Tesla900/GSMLinkModem/Hardware/Info/Smart104.ua_V3_front.png

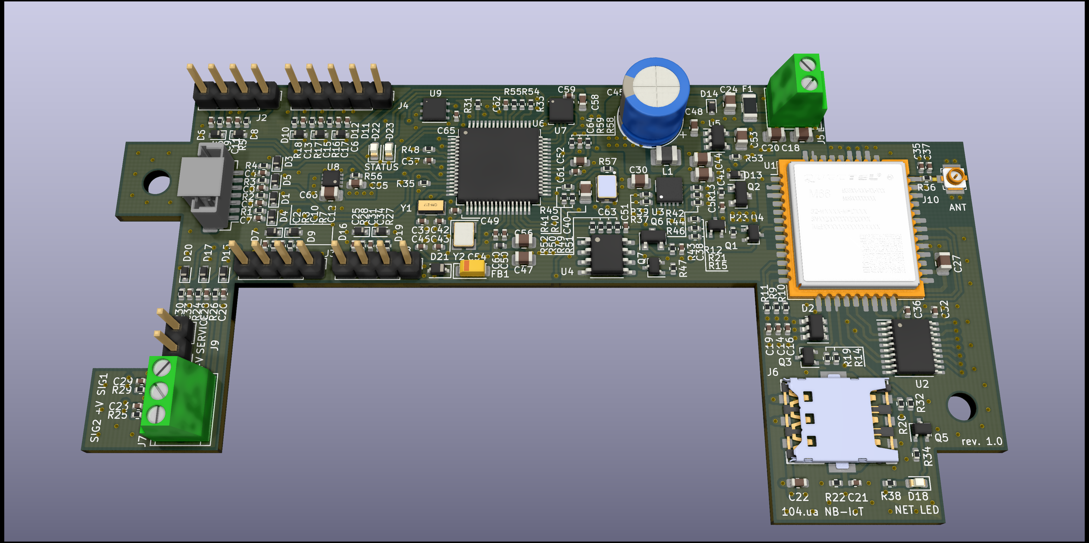
Hardware/Info/Smart104.ua_V3_front.png
