Tesla900/GSMLinkModem/Hardware/Info/Smart104.ua_V3_back.png

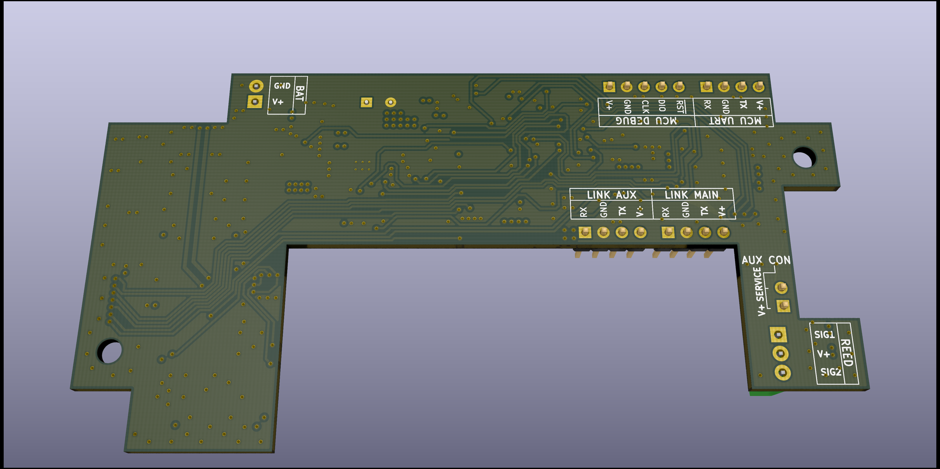
Hardware/Info/Smart104.ua_V3_back.png
