Tesla900/GSMLinkModem/README.md

# GSMLinkModem
EFM32TG222F32-QFP48T+BC66-NA/M66 GSM/GPRS/NB-IoT board
