Tesla900/GSMLinkModem/Hardware/ProductionFiles/assembly/Smart104.ua_V3_BOM.xlsx

Sheet: Лист1
Reference | Value/PartNumber | PartNumber | Qty | Description | Link | DoNotPlace Status
C3, C4, C7-C17, C19, C26, C28, C31, C33, C34 | 18pF | CC0402JRNPO9BN180 | 19 | 18pF ±5% 50V Ceramic Capacitor C0G, NP0 0402 (1005 Metric) | https://www.digikey.com/en/products/detail/yageo/CC0402JRNPO9BN180/2833580
C35, C37, C39, C42, C43, C46 | DNP | ~ | 6 | ~ | ~ | DNP
C45 | 1000uF | A750KK108M0JAAE015 | 1 | 1000µF 6.3V Aluminum - Polymer Capacitors Radial, Can 15mOhm 2000 Hrs @ 105°C | https://www.digikey.com/en/products/detail/kemet/a750kk108m0jaae015/6196437
C22, C48, C52, C55, C58 | 1uF | CC0603KRX7R7BB105 | 5 | 1µF ±10% 16V Ceramic Capacitor X7R 0603 (1608 Metric) | https://www.digikey.com/en/products/detail/yageo/CC0603KRX7R7BB105/2833611
C54 | 100uF | TCJA107M006R0150E | 1 | 100µF Molded Tantalum Polymer Capacitor 6.3V 1206 (3216 Metric) 150mOhm @ 100kHz | https://www.digikey.com/en/products/detail/avx-corporation/TCJA107M006R0150E/10062652
C18, C20, C24, C27, C30, C40, C41, C44, C47, C53, C56, C66 | 10uF | CC0805MKX7R7BB106 | 12 | 10µF ±20% 16V Ceramic Capacitor X7R 0805 (2012 Metric) | digikey.com/en/products/detail/yageo/CC0805MKX7R7BB106/7164392
C1, C2, C5, C6, C21, C23, C25, C29, C32, C36, C38, C49-C51, C57, C59-C62, C64, C65 | 0.1uF | CC0402KRX7R7BB104 | 21 | 0.1µF ±10% 16V Ceramic Capacitor X7R 0402 (1005 Metric) | https://www.digikey.com/en/products/detail/yageo/CC0402KRX7R7BB104/2103076
C63 | 11mF | CPH3225A | 1 | 11mF (EDLC) Supercapacitor 3.3V 1210 (3225 Metric) | https://www.digikey.com/en/products/detail/seiko-instruments/CPH3225A/8692444
D2 | ESDA6V1-5SC6 | ESDA6V1-5SC6 | 1 | Clamp 6.1V 100W TVS Diode Array Surface Mount SOT-23-6 | https://www.digikey.com/en/products/detail/stmicroelectronics/ESDA6V1-5SC6/1037983
D1, D3-D17, D19, D20 | PESD5V0L1UB,115 | PESD5V0L1UB,115 | 18 | 12V Clamp 3.5A (8/20µs) Ipp Tvs Diode Surface Mount SOD-523 | https://www.digikey.com/en/products/detail/nexperia-usa-inc/PESD5V0L1UB115/2092297
D21 | BAT46JFILM | BAT46JFILM | 1 | Diode Schottky 100V 150mA (DC), 0.46Vdrop Surface Mount SOD-323 | https://www.digikey.com/en/products/detail/stmicroelectronics/BAT46JFILM/1037668
D18, D22 | LED_RED | APT1608SURCK | 2 | Red 630nm LED Indication - Discrete 1.95V 0603 (1608 Metric) | https://www.digikey.com/en/products/detail/kingbright/APT1608SURCK/1747522
D23 | LED_GREEN | APT1608CGCK | 1 | Green 570nm LED Indication - Discrete 2.1V 0603 (1608 Metric) | https://www.digikey.com/en/products/detail/kingbright/APT1608CGCK/1747514
F1 | 0ZCJ0100FF2E | 0ZCJ0100FF2E | 1 | Polymeric PTC Resettable Fuse 6V 1A Ih Surface Mount 1206 (3216 Metric), Concave | https://www.digikey.com/en/products/detail/bel-fuse-inc/0ZCJ0100FF2E/4156136
FB1 | 1 kOhms @ 100MHz | BLM15AG102SN1D | 1 | 1 kOhms @ 100MHz 1 Ferrite Bead 0402 (1005 Metric) 300mA 650mOhm | https://www.digikey.com/en/products/detail/murata-electronics/BLM15AG102SN1D/584218
H1, H2 | MountingHole | Mounting screw M3 DIN965 | 2 | Mounting screw M3 DIN965 | ~ | DNP
J1 | 5013310707 | 5013310707 | 1 | Connector Header Surface Mount 7 position 0.039" (1.00mm) | https://www.digikey.com/en/products/detail/molex/5013310707/1531476
J2, J3, J8 | KLS1-207-1-04-S | KLS1-207-1-04-S | 3 | Connector Header Through Hole 4 position 0.100" (2.54mm) | http://www.klsele.com/products/connectors/Pin-Headers-Mini-Jumpers-Series/184.html
J4 | KLS1-207-1-05-S | KLS1-207-1-05-S | 1 | Connector Header Through Hole 5 position 0.100" (2.54mm) | http://www.klsele.com/products/connectors/Pin-Headers-Mini-Jumpers-Series/184.html
J5 | KLS2-308V-2.54-02P-4S | KLS2-308V-2.54-02P-4S | 1 | 2 Position Wire to Board Terminal Block Horizontal with Board 0.100" (2.54mm) Through Hole | http://www.klsele.com/products/Terminal-blocks/560/278.html
J6 | SIM8051-6-0-14-00-A | SIM8051-6-0-14-00-A | 1 | 6 Position Card Connector NANO SIM Surface Mount, Right Angle Gold | https://www.digikey.com/en/products/detail/gct/SIM8051-6-0-14-00-A/10649873?
J7 | KLS2-308V-2.54-03P-4S | KLS2-308V-2.54-03P-4S | 1 | 3 Position Wire to Board Terminal Block Horizontal with Board 0.100" (2.54mm) Through Hole | http://www.klsele.com/products/Terminal-blocks/560/278.html
J9 | KLS1-207-1-02-S | KLS1-207-1-02-S | 1 | Connector Header Through Hole 2 position 0.100" (2.54mm) | http://www.klsele.com/products/connectors/Pin-Headers-Mini-Jumpers-Series/184.html
J10 | 1909763-1 | 1909763-1 | 1 | U.FL (UMCC) Connector Jack, Male Pin 50Ohm Surface Mount Solder | https://www.digikey.com/en/products/detail/te-connectivity-amp-connectors/1909763-1/4731728
L1 | 2.2uH | DFE252010F-2R2M=P2 | 1 | 2.2µH Shielded Inductor 2.3A 97mOhm Max 1008 (2520 Metric) | https://www.digikey.com/en/products/detail/murata-electronics/DFE252010F-2R2M=P2/5812578
Q2, Q6 | AO3419 | AO3419 | 2 | P-Channel 20V 3.5A (Ta) 1.4W (Ta) Surface Mount SOT-23-3L | https://www.digikey.com/en/products/detail/alpha-omega-semiconductor-inc/AO3419/1855785
Q1, Q3-Q5, Q7 | BC847CW,115 | BC847CW,115 | 5 | Bipolar (BJT) Transistor NPN 45V 100mA 100MHz 200mW Surface Mount SOT-323 | https://www.digikey.com/en/products/detail/nexperia-usa-inc/BC847CW115/1232292
R36 | 0R | RC0402JR-070RL | 1 | 0 Ohms 0.063W, 1/16W Chip Resistor 0402 (1005 Metric) Thick Film | https://www.digikey.com/en/products/detail/yageo/RC0402JR-070RL/726406
R40 | 3M | RC0402FR-073ML | 1 | 3 MOhms ±1% 0.125W, 1/8W Chip Resistor 0402 (1005 Metric) Thick Film | https://www.digikey.com/en/products/detail/yageo/RC0402FR-073ML/5917669
R41 | 1M | RC0402FR-071ML | 1 | 1 MOhms ±1% 0.125W, 1/8W Chip Resistor 0402 (1005 Metric) Thick Film | https://www.digikey.com/en/products/detail/yageo/RC0402FR-071ML/726515
R42 | 16.2K | RC0402FR-0716K2L | 1 | 16.2 kOhms ±1% 0.063W, 1/16W Chip Resistor 0402 (1005 Metric) Thick Film | https://www.digikey.com/en/products/detail/yageo/RC0402FR-0716K2L/726545
R44 | 8.25K | RC0402FR-078K25L | 1 | 8.25 kOhms ±1% 0.125W, 1/8W Chip Resistor 0402 (1005 Metric) Thick Film | https://www.digikey.com/en/products/detail/yageo/RC0402FR-078K25L/2827612
R46 | 5.11K | RC0402FR-075K11L | 1 | 5.11 kOhms ±1% 0.125W, 1/8W Chip Resistor 0402 (1005 Metric) Thick Film | https://www.digikey.com/en/products/detail/yageo/RC0402FR-075K11L/2827606
R13, R15, R19, R20, R22, R23, R31, R33-R35, R37, R39, R43, R47, R53, R56 | 10K | RC0402FR-0710KL | 16 | 10 kOhms ±1% 0.063W, 1/16W Chip Resistor 0402 (1005 Metric) Thick Film | https://www.digikey.com/en/products/detail/yageo/RC0402FR-0710KL/726523
R12, R14, R21, R25, R29, R32, R38, R48, R54, R55, R57 | 470R | RC0402FR-07470RL | 11 | 470 Ohms ±5% 0.125W, 1/8W Chip Resistor 0402 (1005 Metric) Thick Film | https://www.digikey.com/en/products/detail/yageo/RC0402FR-07470RL/726619
R1-R11, R16-R18, R24, R26-R28, R30, R45, R49-R52 | 22R | RC0402JR-0722RL | 24 | 22 Ohms ±5% 0.125W, 1/8W Chip Resistor 0402 (1005 Metric) Thick Film | https://www.digikey.com/en/products/detail/yageo/RC0402JR-0722RL/726444
R58, R59 | 4.7K | RC0402JR-074K7L | 2 | 4.7 kOhms ±5% 0.125W, 1/8W Chip Resistor 0805 (2012 Metric) Thick Film | https://www.digikey.com/en/products/detail/yageo/RC0402JR-074K7L/726477
U1 | BC66NADA-04-STD | BC66NADA-04-STD | 1 | Cellular GPRS, GSM, LTE, NB-IOT Transceiver Module Antenna Not Included Surface Mount | https://www.digikey.com/en/products/detail/quectel/BC66NADA-04-STD/13278325
U2 | TXS0108EPW | TXS0108EPW | 1 | Voltage Level Translator Bidirectional 1 Circuit 8 Channel 60Mbps 20-TSSOP | https://www.digikey.com/en/products/detail/texas-instruments/TXS0108EPWR/1775302
U3 | TPS63900 | TPS63900DSKR | 1 | Buck-Boost Switching Regulator IC Positive Programmable 1.8V 1 Output 10-WFDFN Exposed Pad | https://www.digikey.com/en/products/detail/texas-instruments/TPS63900DSKR/13535479
U4 | AT25SF321B-SSHB-T | AT25SF321B-SSHB-T | 1 | FLASH - NOR Memory IC 32Mb (4M x 8) SPI - Quad I/O 108MHz 8-SOIC | https://www.digikey.com/en/products/detail/adesto-technologies/AT25SF321B-SSHB-T/10280630
U5 | MIC5504-3.3YM5 | MIC5504-3.3YM5 | 1 | Linear Voltage Regulator IC 1 Output 3.3V 300mA SOT-23-5 | https://www.digikey.com/en/products/detail/microchip-technology/MIC5504-3-3YM5-TR/4864018
U6 | EFM32TG11B320F128GQ64-B | EFM32TG11B320F128GQ64-B | 1 | ARM Cortex-M0+ Tiny Gecko 1 Microcontroller IC 32-Bit 48MHz 128KB (128K x 8) FLASH 64-TQFP (10x10) | https://www.digikey.com/en/products/detail/silicon-labs/EFM32TG11B320F128GQ64-B/9677681
U7 | LIS3DH | LIS3DH | 1 | Accelerometer X, Y, Z Axis ±2g, 4g, 8g, 16g 0.5Hz ~ 625Hz 16-LGA (3x3) | https://www.digikey.com/en/products/detail/stmicroelectronics/LIS3DHTR/2334338 | DNP
U8 | MCP1727-3302E_MF | MCP1727-3302E_MF | 1 | Linear Voltage Regulator IC 1 Output 3.3V 1.5A 8-DFN-EP (3x3) | https://www.digikey.com/en/products/detail/microchip-technology/MCP1727-3302E-MF/1098483
U9 | Si7055-A20 | Si7055-A20 | 1 | Temperature Sensor Digital, Local -40°C ~ 125°C 14 b 6-DFN (3x3) | https://www.digikey.com/en/products/detail/silicon-labs/SI7055-A20-IM/5025891
Y1 | 32.768kHz | CM315D32768DZFT | 1 | 32.768kHz ±20ppm Crystal 12.5pF 70 kOhms 2-SMD, No Lead | https://www.digikey.com/en/products/detail/citizen-finedevice-co-ltd/CM315D32768DZFT/3641380
Y2 | ABM8-48-000MHZ | ABM8-48.000MHZ-10-1-U-T | 1 | 48MHz ±10ppm Crystal 10pF 35 Ohms 4-SMD, No Lead | https://www.digikey.com/en/products/detail/abracon-llc/ABM8-48-000MHZ-10-1-U-T/8582029
DNP -Do Not Place

Sheet: Лист2
C3, C4, C7-C17, C19, C26, C28, C31, C33, C34 | 18pF | Capacitor_SMD:C_0402_1005Metric | https://www.digikey.com/en/products/detail/yageo/CC0402JRNPO9BN180/2833580 | 18pF ±5% 50V Ceramic Capacitor C0G, NP0 0402 (1005 Metric) |  | CC0402JRNPO9BN180 | 19
C35, C37, C39, C42, C43, C46 | DNP | Capacitor_SMD:C_0402_1005Metric | ... |  | DNP |  | 6
C45 | 1000uF | Capacitor_THT:CP_Radial_D8.0mm_P3.50mm | https://www.digikey.com/en/products/detail/kemet/a750kk108m0jaae015/6196437 | 1000µF 6.3V Aluminum - Polymer Capacitors Radial, Can 15mOhm 2000 Hrs @ 105°C |  | A750KK108M0JAAE015 | 1
C22, C48, C52, C55, C58 | 1uF | Capacitor_SMD:C_0603_1608Metric | https://www.digikey.com/en/products/detail/yageo/CC0603KRX7R7BB105/2833611 | 1µF ±10% 16V Ceramic Capacitor X7R 0603 (1608 Metric) |  | CC0603KRX7R7BB105 | 5
C54 | 100uF | Capacitor_Tantalum_SMD:CP_EIA-3216-18_Kemet-A | https://www.digikey.com/en/products/detail/avx-corporation/TCJA107M006R0150E/10062652 | 100µF Molded Tantalum Polymer Capacitor 6.3V 1206 (3216 Metric) 150mOhm @ 100kHz |  | TCJA107M006R0150E | 1
C18, C20, C24, C27, C30, C40, C41, C44, C47, C53, C56, C66 | 10uF | Capacitor_SMD:C_0805_2012Metric | digikey.com/en/products/detail/yageo/CC0805MKX7R7BB106/7164392 | 10µF ±20% 16V Ceramic Capacitor X7R 0805 (2012 Metric) |  | CC0805MKX7R7BB106 | 12
C1, C2, C5, C6, C21, C23, C25, C29, C32, C36, C38, C49-C51, C57, C59-C62, C64, C65 | 0.1uF | Capacitor_SMD:C_0402_1005Metric | https://www.digikey.com/en/products/detail/yageo/CC0402KRX7R7BB104/2103076 | 0.1µF ±10% 16V Ceramic Capacitor X7R 0402 (1005 Metric) |  | CC0402KRX7R7BB104 | 21
C63 | 11mF | mylib-footprints:CAPCP3225X100N | https://www.digikey.com/en/products/detail/seiko-instruments/CPH3225A/8692444 | 11mF (EDLC) Supercapacitor 3.3V 1210 (3225 Metric) |  | CPH3225A | 1
D2 | ESDA6V1-5SC6 | Package_TO_SOT_SMD:SOT-23-6 | https://www.digikey.com/en/products/detail/stmicroelectronics/ESDA6V1-5SC6/1037983 | Clamp 6.1V 100W TVS Diode Array Surface Mount SOT-23-6 |  | ESDA6V1-5SC6 | 1
D1, D3-D17, D19, D20 | PESD5V0L1UB,115 | Diode_SMD:D_SOD-523 | https://www.digikey.com/en/products/detail/nexperia-usa-inc/PESD5V0L1UB115/2092297 | 12V Clamp 3.5A (8/20µs) Ipp Tvs Diode Surface Mount SOD-523 |  | PESD5V0L1UB,115 | 18
D21 | BAT46JFILM | Diode_SMD:D_SOD-323 | https://www.digikey.com/en/products/detail/stmicroelectronics/BAT46JFILM/1037668 | Diode Schottky 100V 150mA (DC), 0.46Vdrop Surface Mount SOD-323 |  | BAT46JFILM | 1
D18, D22 | LED_RED | LED_SMD:LED_0603_1608Metric | https://www.digikey.com/en/products/detail/kingbright/APT1608SURCK/1747522 | Red 630nm LED Indication - Discrete 1.95V 0603 (1608 Metric) |  | APT1608SURCK | 2
D23 | LED_GREEN | LED_SMD:LED_0603_1608Metric | https://www.digikey.com/en/products/detail/kingbright/APT1608CGCK/1747514 | Green 570nm LED Indication - Discrete 2.1V 0603 (1608 Metric) |  | APT1608CGCK | 1
F1 | 0ZCJ0100FF2E | Fuse:Fuse_1206_3216Metric | https://www.digikey.com/en/products/detail/bel-fuse-inc/0ZCJ0100FF2E/4156136 | Polymeric PTC Resettable Fuse 6V 1A Ih Surface Mount 1206 (3216 Metric), Concave |  | 0ZCJ0100FF2E | 1
FB1 | 1 kOhms @ 100MHz | Inductor_SMD:L_0402_1005Metric | https://www.digikey.com/en/products/detail/murata-electronics/BLM15AG102SN1D/584218 | 1 kOhms @ 100MHz 1 Ferrite Bead 0402 (1005 Metric) 300mA 650mOhm |  | BLM15AG102SN1D | 1
H1, H2 | MountingHole | MountingHole:MountingHole_3.2mm_M3 | ~ | Mounting screw M3 DIN965 |  | Mounting screw M3 DIN965 | 2
J1 | 5013310707 | Connector_Molex:Molex_Pico-Clasp_501331-0707_1x07-1MP_P1.00mm_Vertical | https://www.digikey.com/en/products/detail/molex/5013310707/1531476 | Connector Header Surface Mount 7 position 0.039" (1.00mm) |  | 5013310707 | 1
J2, J3, J8 | KLS1-207-1-04-S | Connector_PinHeader_2.54mm:PinHeader_1x04_P2.54mm_Vertical | http://www.klsele.com/products/connectors/Pin-Headers-Mini-Jumpers-Series/184.html | Connector Header Through Hole 4 position 0.100" (2.54mm) |  | KLS1-207-1-04-S | 3
J4 | KLS1-207-1-05-S | Connector_PinHeader_2.54mm:PinHeader_1x05_P2.54mm_Vertical | http://www.klsele.com/products/connectors/Pin-Headers-Mini-Jumpers-Series/184.html | Connector Header Through Hole 5 position 0.100" (2.54mm) |  | KLS1-207-1-05-S | 1
J5 | KLS2-308V-2.54-02P-4S | TerminalBlock_TE-Connectivity:TerminalBlock_TE_282834-2_1x02_P2.54mm_Horizontal | http://www.klsele.com/products/Terminal-blocks/560/278.html | 2 Position Wire to Board Terminal Block Horizontal with Board 0.100" (2.54mm) Through Hole |  | KLS2-308V-2.54-02P-4S | 1
J6 | SIM8051-6-0-14-00-A | mylib-footprints:GCT_SIM8051-6-0-14-00-X-REVD | https://www.digikey.com/en/products/detail/gct/SIM8051-6-0-14-00-A/10649873? | 6 Position Card Connector NANO SIM Surface Mount, Right Angle Gold |  | SIM8051-6-0-14-00-A | 1
J7 | KLS2-308V-2.54-03P-4S | TerminalBlock_TE-Connectivity:TerminalBlock_TE_282834-3_1x03_P2.54mm_Horizontal | http://www.klsele.com/products/Terminal-blocks/560/278.html | 3 Position Wire to Board Terminal Block Horizontal with Board 0.100" (2.54mm) Through Hole |  | KLS2-308V-2.54-03P-4S | 1
J9 | KLS1-207-1-02-S | Connector_PinHeader_2.54mm:PinHeader_1x02_P2.54mm_Vertical | http://www.klsele.com/products/connectors/Pin-Headers-Mini-Jumpers-Series/184.html | Connector Header Through Hole 2 position 0.100" (2.54mm) |  | KLS1-207-1-02-S | 1
J10 | 1909763-1 | digikey-footprints:UMCoax_Pin_1909763-1 | https://www.digikey.com/en/products/detail/te-connectivity-amp-connectors/1909763-1/4731728 | U.FL (UMCC) Connector Jack, Male Pin 50Ohm Surface Mount Solder |  | 1909763-1 | 1
L1 | 2.2uH | Inductor_SMD:L_1008_2520Metric_Pad1.43x2.20mm_HandSolder | https://www.digikey.com/en/products/detail/murata-electronics/DFE252010F-2R2M=P2/5812578 | 2.2µH Shielded Inductor 2.3A 97mOhm Max 1008 (2520 Metric) |  | DFE252010F-2R2M=P2 | 1
Q2, Q6 | AO3419 | Package_TO_SOT_SMD:SOT-23 | https://www.digikey.com/en/products/detail/alpha-omega-semiconductor-inc/AO3419/1855785 | P-Channel 20V 3.5A (Ta) 1.4W (Ta) Surface Mount SOT-23-3L |  | AO3419 | 2
Q1, Q3-Q5, Q7 | BC847CW,115 | Package_TO_SOT_SMD:SOT-323_SC-70 | https://www.digikey.com/en/products/detail/nexperia-usa-inc/BC847CW115/1232292 | Bipolar (BJT) Transistor NPN 45V 100mA 100MHz 200mW Surface Mount SOT-323 |  | BC847CW,115 | 5
R36 | 0R | Resistor_SMD:R_0402_1005Metric | https://www.digikey.com/en/products/detail/yageo/RC0402JR-070RL/726406 | 0 Ohms 0.063W, 1/16W Chip Resistor 0402 (1005 Metric) Thick Film |  | RC0402JR-070RL | 1
R40 | 3M | Resistor_SMD:R_0402_1005Metric | https://www.digikey.com/en/products/detail/yageo/RC0402FR-073ML/5917669 | 3 MOhms ±1% 0.125W, 1/8W Chip Resistor 0402 (1005 Metric) Thick Film |  | RC0402FR-073ML | 1
R41 | 1M | Resistor_SMD:R_0402_1005Metric | https://www.digikey.com/en/products/detail/yageo/RC0402FR-071ML/726515 | 1 MOhms ±1% 0.125W, 1/8W Chip Resistor 0402 (1005 Metric) Thick Film |  | RC0402FR-071ML | 1
R42 | 16.2K | Resistor_SMD:R_0402_1005Metric | https://www.digikey.com/en/products/detail/yageo/RC0402FR-0716K2L/726545 | 16.2 kOhms ±1% 0.063W, 1/16W Chip Resistor 0402 (1005 Metric) Thick Film |  | RC0402FR-0716K2L | 1
R44 | 8.25K | Resistor_SMD:R_0402_1005Metric | https://www.digikey.com/en/products/detail/yageo/RC0402FR-078K25L/2827612 | 8.25 kOhms ±1% 0.125W, 1/8W Chip Resistor 0402 (1005 Metric) Thick Film |  | RC0402FR-078K25L | 1
R46 | 5.11K | Resistor_SMD:R_0402_1005Metric | https://www.digikey.com/en/products/detail/yageo/RC0402FR-075K11L/2827606 | 5.11 kOhms ±1% 0.125W, 1/8W Chip Resistor 0402 (1005 Metric) Thick Film |  | RC0402FR-075K11L | 1
R13, R15, R19, R20, R22, R23, R31, R33-R35, R37, R39, R43, R47, R53, R56 | 10K | Resistor_SMD:R_0402_1005Metric | https://www.digikey.com/en/products/detail/yageo/RC0402FR-0710KL/726523 | 10 kOhms ±1% 0.063W, 1/16W Chip Resistor 0402 (1005 Metric) Thick Film |  | RC0402FR-0710KL | 16
R12, R14, R21, R25, R29, R32, R38, R48, R54, R55, R57 | 470R | Resistor_SMD:R_0402_1005Metric | https://www.digikey.com/en/products/detail/yageo/RC0402FR-07470RL/726619 | 470 Ohms ±5% 0.125W, 1/8W Chip Resistor 0402 (1005 Metric) Thick Film |  | RC0402FR-07470RL | 11
R1-R11, R16-R18, R24, R26-R28, R30, R45, R49-R52 | 22R | Resistor_SMD:R_0402_1005Metric | https://www.digikey.com/en/products/detail/yageo/RC0402JR-0722RL/726444 | 22 Ohms ±5% 0.125W, 1/8W Chip Resistor 0402 (1005 Metric) Thick Film |  | RC0402JR-0722RL | 24
R58, R59 | 4.7K | Resistor_SMD:R_0402_1005Metric | https://www.digikey.com/en/products/detail/yageo/RC0402JR-074K7L/726477 | 4.7 kOhms ±5% 0.125W, 1/8W Chip Resistor 0805 (2012 Metric) Thick Film |  | RC0402JR-074K7L | 2
U1 | BC66NADA-04-STD | mylib-footprints:Quectel_BC66 | https://www.digikey.com/en/products/detail/quectel/BC66NADA-04-STD/13278325?s=N4IgTCBcDaIEYGMBsSC0A7AhiAugXyA | Cellular GPRS, GSM, LTE, NB-IOT Transceiver Module Antenna Not Included Surface Mount |  | BC66NADA-04-STD | 1
U2 | TXS0108EPW | Package_SO:TSSOP-20_4.4x6.5mm_P0.65mm | https://www.digikey.com/en/products/detail/texas-instruments/TXS0108EPWR/1775302 | Voltage Level Translator Bidirectional 1 Circuit 8 Channel 60Mbps 20-TSSOP |  | TXS0108EPW | 1
U3 | TPS63900 | Package_DFN_QFN:DFN-10-1EP_3x3mm_P0.5mm_EP1.65x2.38mm_ThermalVias | https://www.digikey.com/en/products/detail/texas-instruments/TPS63900DSKR/13535479 | Buck-Boost Switching Regulator IC Positive Programmable 1.8V 1 Output 10-WFDFN Exposed Pad |  | TPS63900DSKR | 1
U4 | AT25SF321B-SSHB-T | Package_SO:SOIC-8_3.9x4.9mm_P1.27mm | https://www.digikey.com/en/products/detail/adesto-technologies/AT25SF321B-SSHB-T/10280630 | FLASH - NOR Memory IC 32Mb (4M x 8) SPI - Quad I/O 108MHz 8-SOIC |  | AT25SF321B-SSHB-T | 1
U5 | MIC5504-3.3YM5 | Package_TO_SOT_SMD:SOT-23-5 | https://www.digikey.com/en/products/detail/microchip-technology/MIC5504-3-3YM5-TR/4864018 | Linear Voltage Regulator IC 1 Output 3.3V 300mA SOT-23-5 |  | MIC5504-3.3YM5 | 1
U6 | EFM32TG11B320F128GQ64-B | Package_QFP:TQFP-64_10x10mm_P0.5mm | https://www.digikey.com/en/products/detail/silicon-labs/EFM32TG11B320F128GQ64-B/9677681 | ARM Cortex-M0+ Tiny Gecko 1 Microcontroller IC 32-Bit 48MHz 128KB (128K x 8) FLASH 64-TQFP (10x10) |  | EFM32TG11B320F128GQ64-B | 1
U7 | LIS3DH | Package_LGA:LGA-16_3x3mm_P0.5mm_LayoutBorder3x5y | https://www.digikey.com/en/products/detail/stmicroelectronics/LIS3DHTR/2334338 | Accelerometer X, Y, Z Axis ±2g, 4g, 8g, 16g 0.5Hz ~ 625Hz 16-LGA (3x3) |  | LIS3DH | 1
U8 | MCP1727-3302E_MF | Package_DFN_QFN:VDFN-8-1EP_2x2mm_P0.5mm_EP0.9x1.7mm | https://www.digikey.com/en/products/detail/microchip-technology/MCP1727-3302E-MF/1098483 | Linear Voltage Regulator IC 1 Output 3.3V 1.5A 8-DFN-EP (3x3) |  | MCP1727-3302E_MF | 1
U9 | Si7055-A20 | Package_DFN_QFN:DFN-6-1EP_3x3mm_P1mm_EP1.5x2.4mm | https://www.digikey.com/en/products/detail/silicon-labs/SI7055-A20-IM/5025891 | Temperature Sensor Digital, Local -40°C ~ 125°C 14 b 6-DFN (3x3) |  | Si7055-A20 | 1
Y1 | 32.768kHz | Crystal:Crystal_SMD_3215-2Pin_3.2x1.5mm | https://www.digikey.com/en/products/detail/citizen-finedevice-co-ltd/CM315D32768DZFT/3641380 | 32.768kHz ±20ppm Crystal 12.5pF 70 kOhms 2-SMD, No Lead |  | CM315D32768DZFT | 1
Y2 | ABM8-48-000MHZ | Crystal:Crystal_SMD_3225-4Pin_3.2x2.5mm | https://www.digikey.com/en/products/detail/abracon-llc/ABM8-48-000MHZ-10-1-U-T/8582029 | 48MHz ±10ppm Crystal 10pF 35 Ohms 4-SMD, No Lead | DNP | ABM8-48.000MHZ-10-1-U-T | 1
