Tesla900/GSMLinkModem/Hardware/Info/ConnectorsLayout.xlsx

Ref№ | Description | Pinout
J1 | External sensors connector | 1 | +3V3 Power | RF module connectors
 |  | 2 | +BAT | MCU connectors
 |  | 3 | GPIO0 | Power connectors
 |  | 4 | GPIO1
 |  | 5 | ADC0
 |  | 6 | ADC1
 |  | 7 | GND
J2 | MCU UART connector | 1 | MCU RX
 |  | 2 | GND
 |  | 3 | MCU TX
 |  | 4 | VCC
J3 | Modem main UART connector | 1 | Modem RX
 |  | 2 | GND
 |  | 3 | Modem TX
 |  | 4 | VCC
J4 | MCU Debug SWD | 1 | VCC
 |  | 2 | GND
 |  | 3 | SWCLK
 |  | 4 | SWDIO
 |  | 5 | RESET
J5 | Power in | 1 | VCC
 |  | 2 | GND
J6 | SIM card | Standart pinout
J7 | Reed switch connector | 1 | Signal input 1
 |  | 2 | VCC output
 |  | 3 | Signal input 2
J8 | Modem debug UART connector | 1 | Modem RX
 |  | 2 | GND
 |  | 3 | Modem TX
 |  | 4 | VCC
J9 | Service connector | 1 | VCC output
 |  | 2 | Signal in/out
J10 | Antenna connector | 1 | RF in/out
 |  | 2 | GND
