Tesla900/GSMLinkModem/Hardware/Info/Smart104.ua_V3_rev2_schematic.pdf

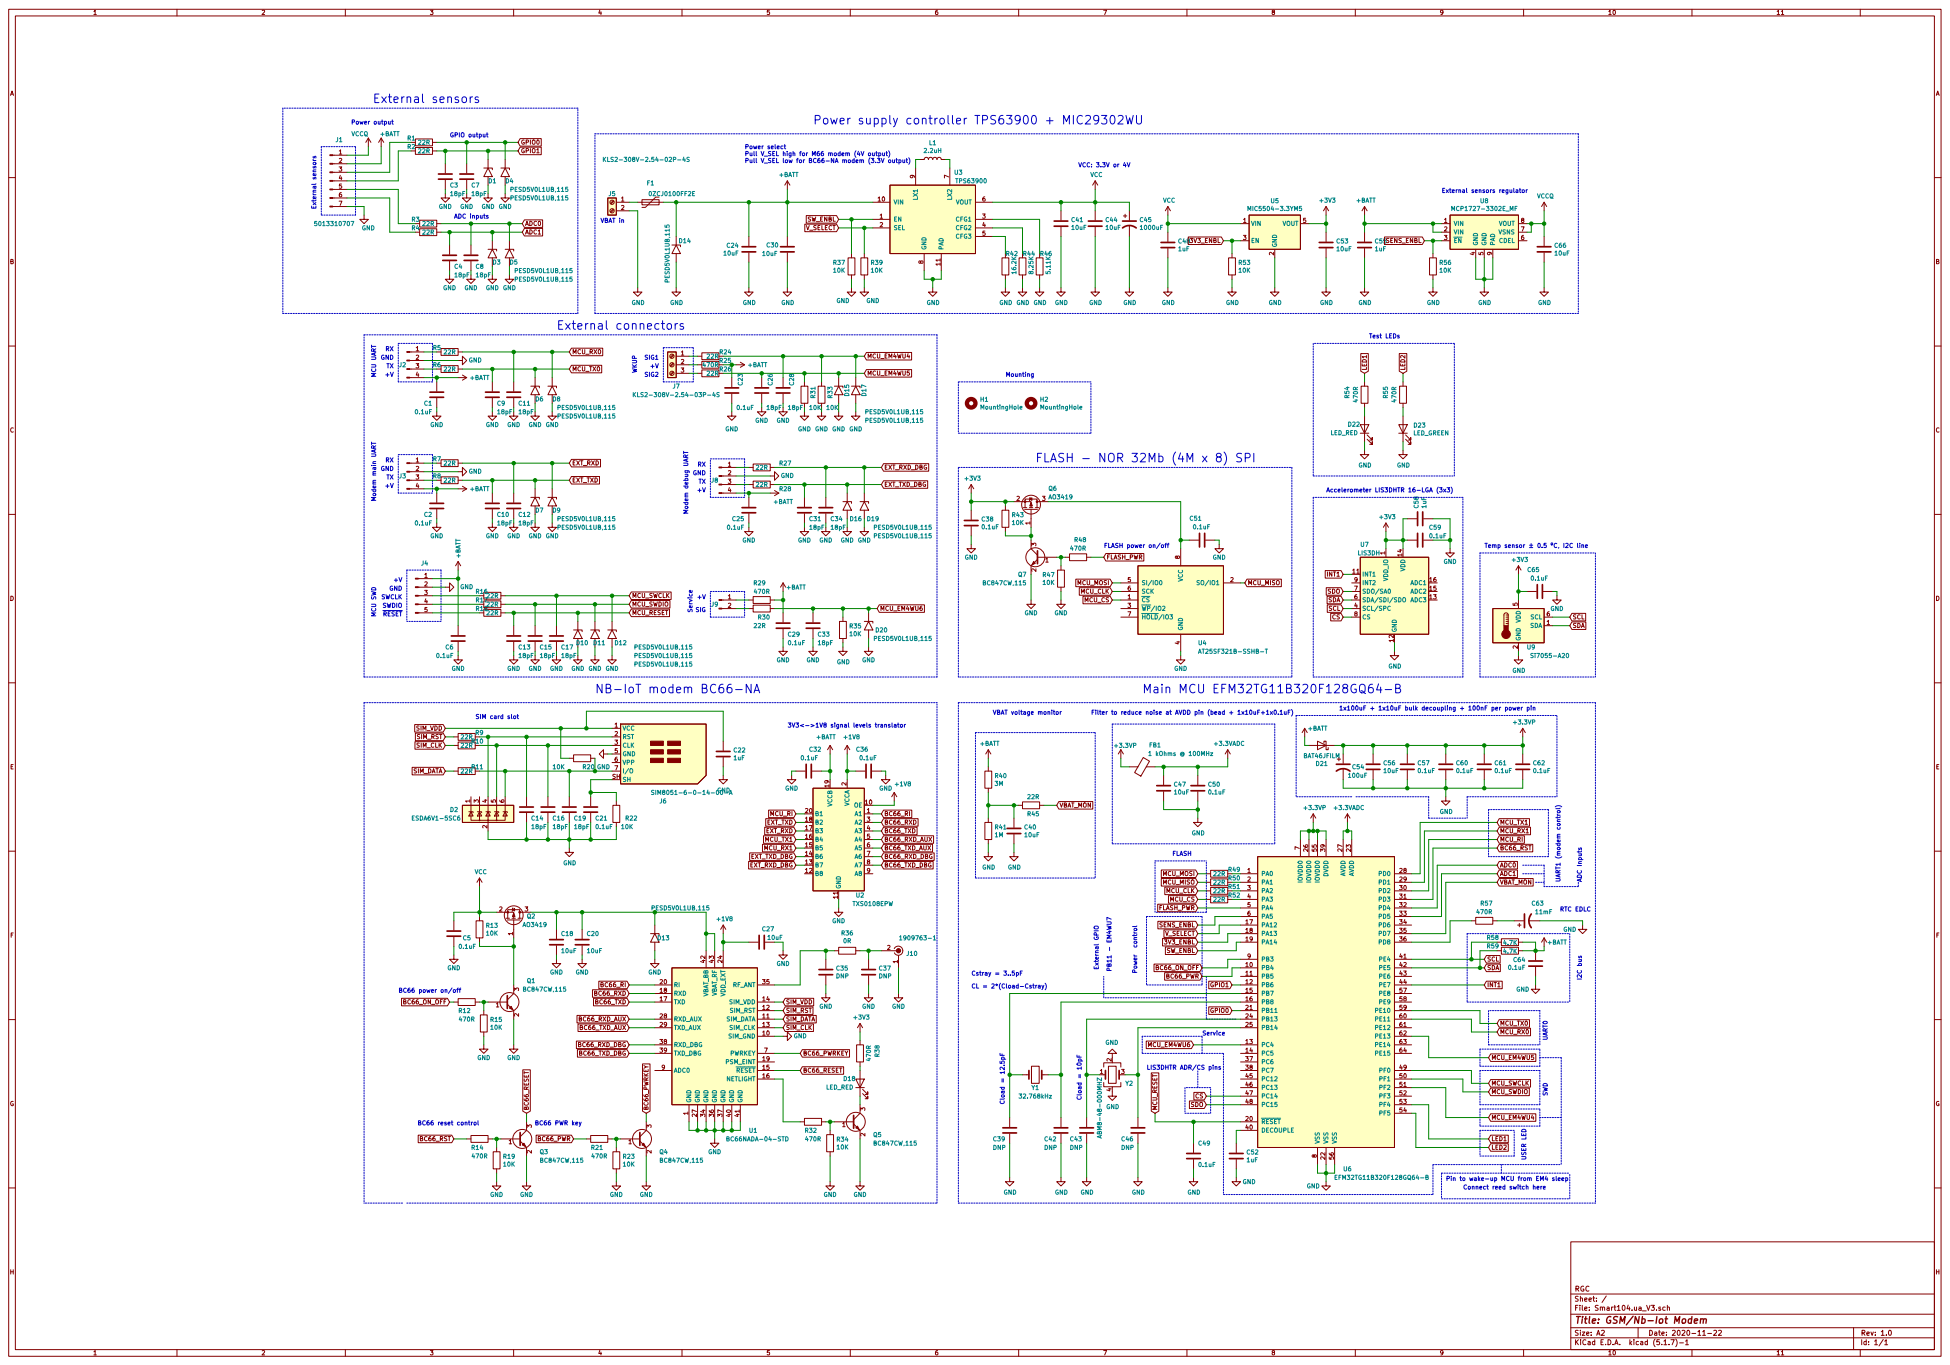
[picture p3: page 1]

Power select Pull V_SEL high for M66 modem (4V output)
+BATT GND

Test LEDs External connectors

FLASH power on/off

Temp sensor ± 0.5 ºC, I2C line

Filter to reduce noise at AVDD pin (bead + 1x10uF+1x0.1uF)

VCC 1 RST 2 CLK 3 GND 5 VPP 6

Connect reed switch here Pin to wake-up MCU from EM4 sleep

Id: 1/1 Title: GSM/Nb-Iot Modem
