Tesla900/GSMLinkModem/Hardware/Smart104.ua_V3_rev2.kicad_pcb

## KiCad design Hardware/Smart104.ua_V3_rev2.kicad_pcb (2021-01-17)

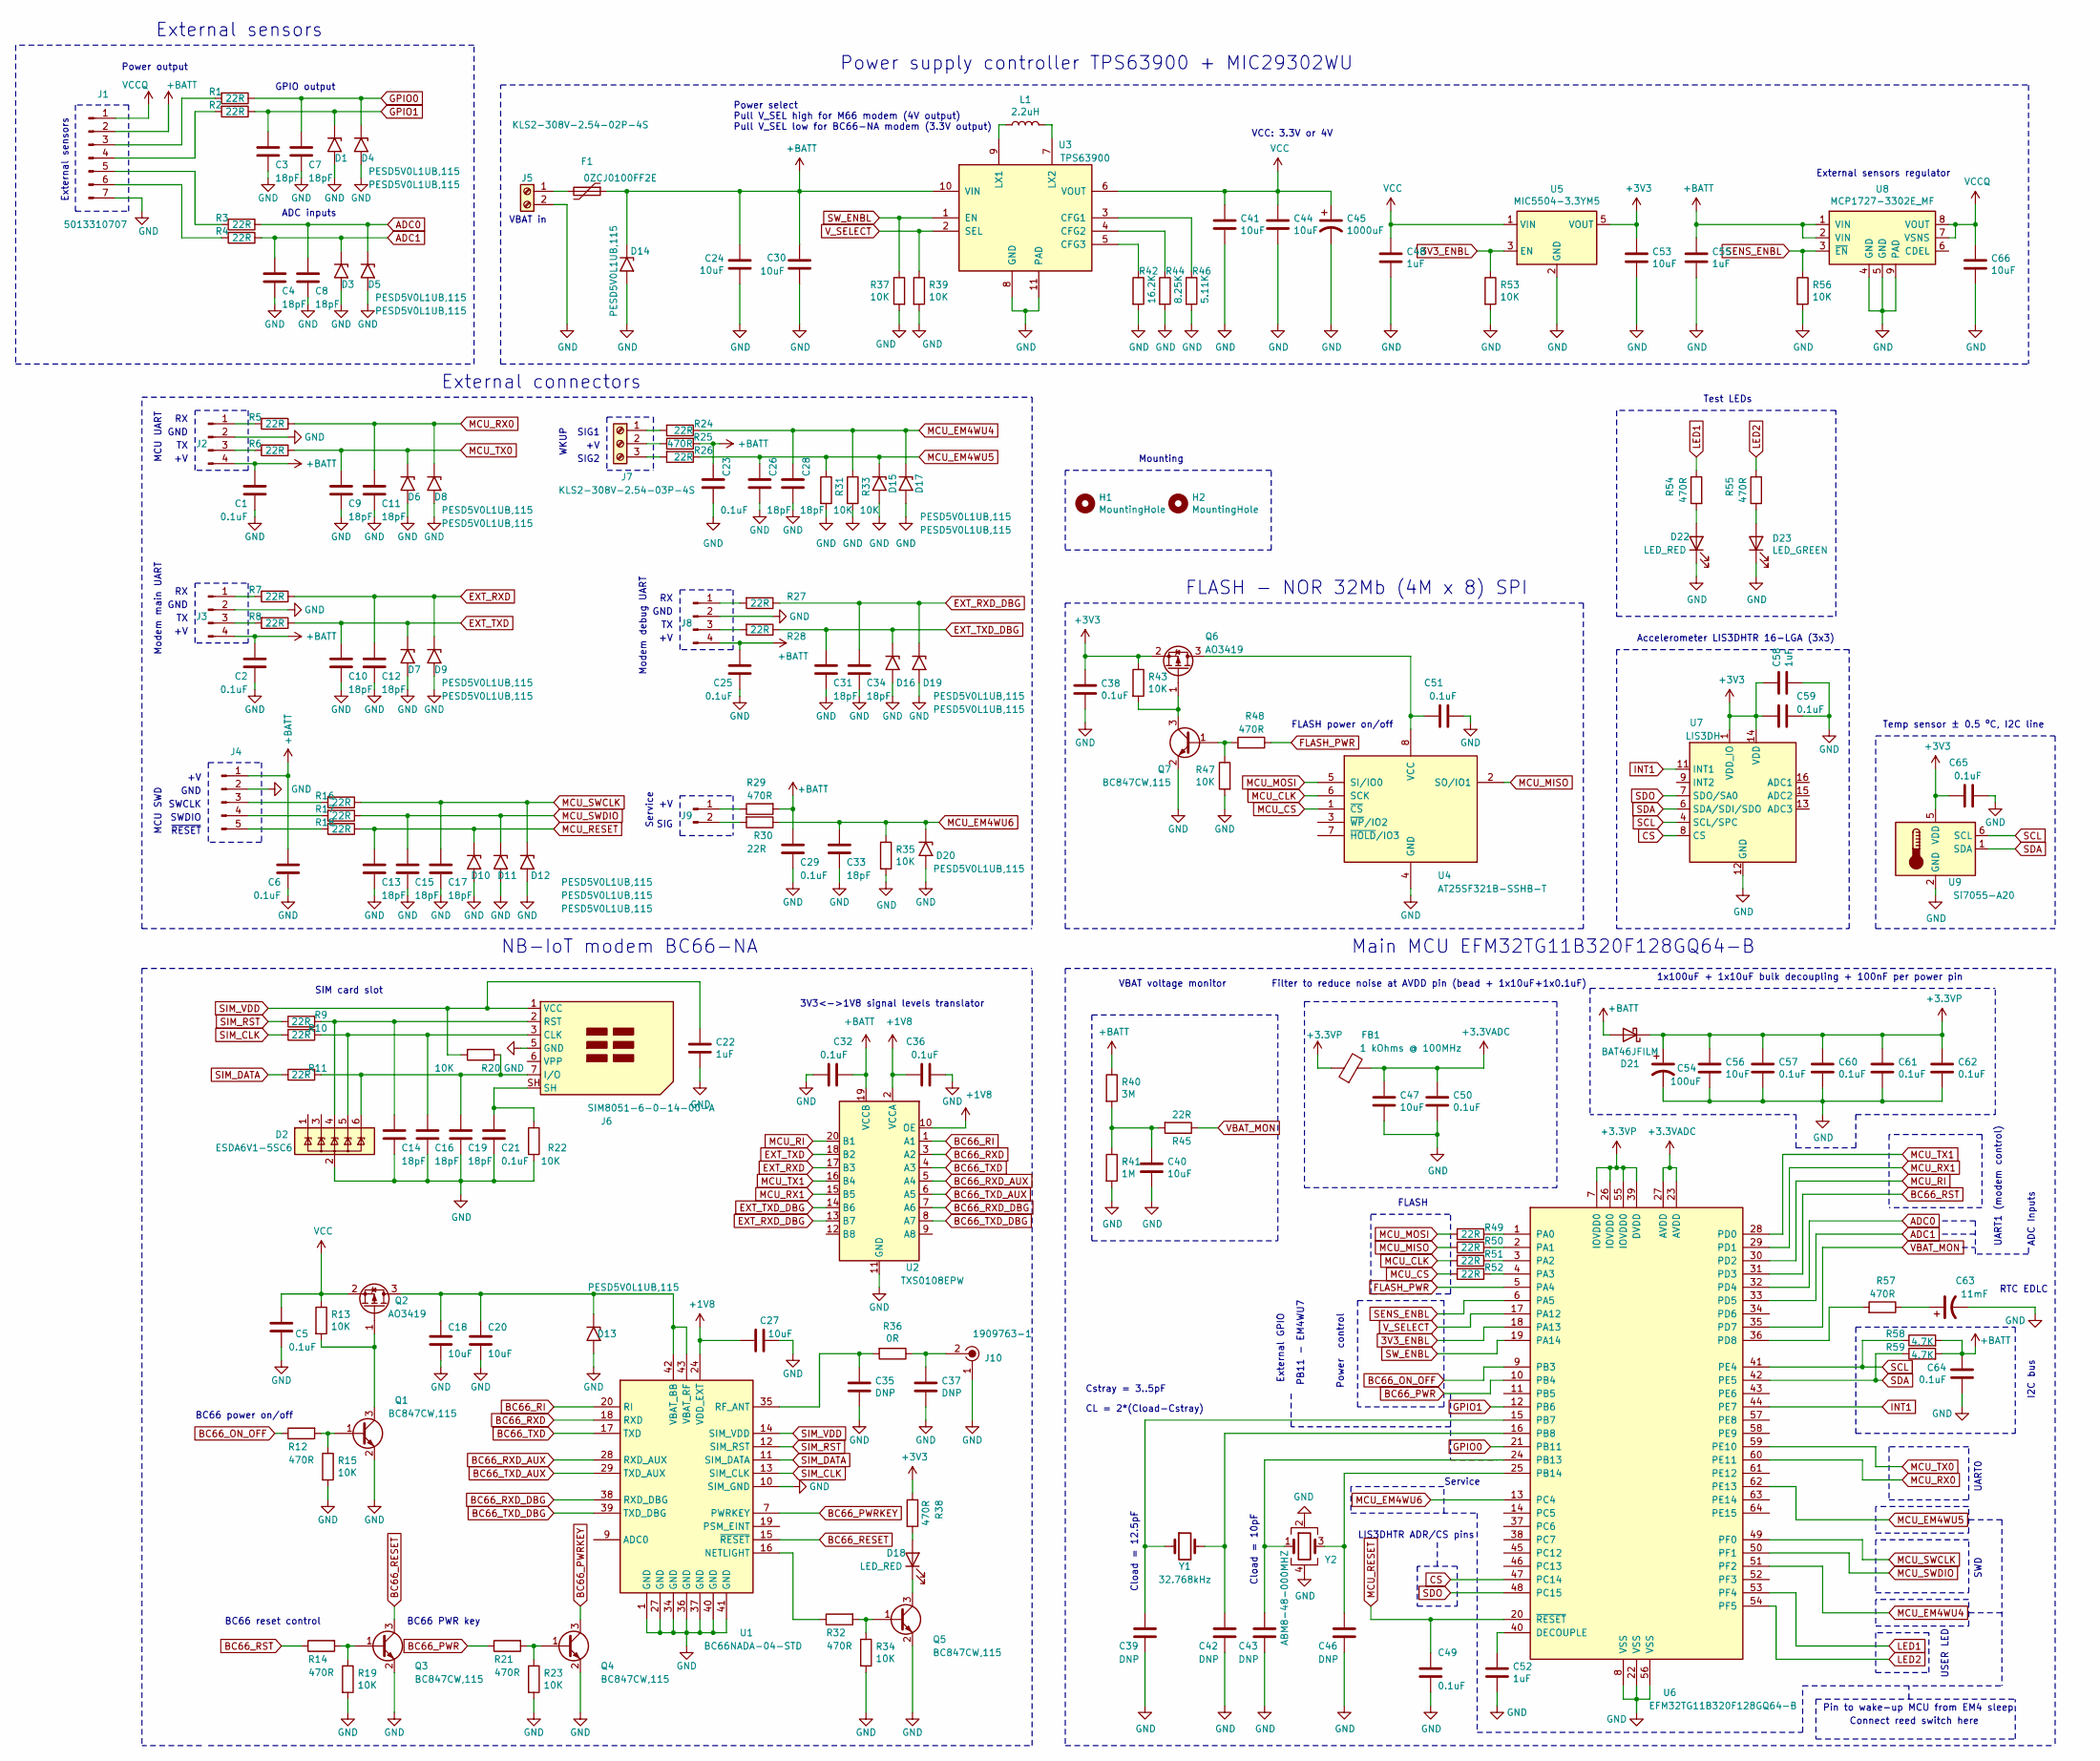
[picture p12: schematic Smart104.ua_V3_rev2.sch, GSM/Nb-Iot Modem]

Parts:
C1, C2, C5, C6, C21, C23, C25, C29, C32, C36, C38, C49, C50, C51, C57, C59, C60, C61, C62, C64, C65: 0.1uF; C_0402_1005Metric; Voltage 25V; PartNumber CC0402KRX7R7BB104
C3, C4, C7, C8, C9, C10, C11, C12, C13, C14, C15, C16, C17, C19, C26, C28, C31, C33, C34: 18pF; C_0402_1005Metric; Voltage 50V; PartNumber CC0402JRNPO9BN180
C18, C20, C24, C27, C30, C40, C41, C44, C47, C53, C56, C66: 10uF; C_0805_2012Metric; Voltage 25V; PartNumber CC0805MKX7R7BB106
C22, C48, C52, C55, C58: 1uF; C_0603_1608Metric; Voltage 25V; PartNumber CC0603KRX7R7BB105
C35, C37: DNP; C_0402_1005Metric
C39, C42, C43, C46: DNP; C_0402_1005Metric; Voltage 50V
C45: 1000uF; CP_Radial_D8.0mm_P3.50mm; Voltage 6.3V; PartNumber A750KK108M0JAAE015
C54: 100uF; CP_EIA-3216-18_Kemet-A; Voltage 6.3V; PartNumber TCJA107M006R0150E
C63: 11mF; CAPCP3225X100N; Voltage 3.3V; PartNumber CPH3225A
D1, D3, D4, D5, D6, D7, D8, D9, D10, D11, D12, D13, D14, D15, D16, D17, D19, D20: PESD5V0L1UB,115; D_SOD-523; PartNumber PESD5V0L1UB,115
D2: ESDA6V1-5SC6; SOT-23-6; PartNumber ESDA6V1-5SC6
D18, D22: LED_RED; LED_0603_1608Metric; PartNumber APT1608SURCK
D21: BAT46JFILM; D_SOD-323; PartNumber BAT46JFILM
D23: LED_GREEN; LED_0603_1608Metric; PartNumber APT1608CGCK
F1: 0ZCJ0100FF2E; Fuse_1206_3216Metric; PartNumber 0ZCJ0100FF2E
FB1: 1 kOhms @ 100MHz; L_0402_1005Metric; PartNumber BLM15AG102SN1D
H1, H2: MountingHole; MountingHole_3.2mm_M3; PartNumber Mounting screw M3 DIN965
J1: 5013310707; Molex_Pico-Clasp_501331-0707_1x07-1MP_P1.00mm_Vertical; PartNumber 5013310707
J2, J3, J8: KLS1-207-1-04-S; PinHeader_1x04_P2.54mm_Vertical; PartNumber KLS1-207-1-04-S
J4: KLS1-207-1-05-S; PinHeader_1x05_P2.54mm_Vertical; PartNumber KLS1-207-1-05-S
J5: KLS2-308V-2.54-02P-4S; TerminalBlock_TE_282834-2_1x02_P2.54mm_Horizontal; PartNumber KLS2-308V-2.54-02P-4S
J6: SIM8051-6-0-14-00-A; GCT_SIM8051-6-0-14-00-X-REVD; PartNumber SIM8051-6-0-14-00-A
J7: KLS2-308V-2.54-03P-4S; TerminalBlock_TE_282834-3_1x03_P2.54mm_Horizontal; PartNumber KLS2-308V-2.54-03P-4S
J9: KLS1-207-1-02-S; PinHeader_1x02_P2.54mm_Vertical; PartNumber KLS1-207-1-02-S
J10: 1909763-1; UMCoax_Pin_1909763-1; PartNumber 1909763-1
L1: 2.2uH; L_1008_2520Metric_Pad1.43x2.20mm_HandSolder; PartNumber DFE252010F-2R2M=P2
Q1, Q3, Q4, Q5, Q7: BC847CW,115; SOT-323_SC-70; PartNumber BC847CW,115
Q2, Q6: AO3419; SOT-23; PartNumber AO3419
R1, R2, R3, R4, R5, R6, R7, R8, R9, R10, R11, R16, R17, R18, R24, R26, R27, R28, R30, R45, R49, R50, R51, R52: 22R; R_0402_1005Metric; PartNumber RC0402JR-0722RL
R12, R14, R21, R25, R29, R32, R38, R48, R54, R55, R57: 470R; R_0402_1005Metric; PartNumber RC0402FR-07470RL
R13, R15, R19, R20, R22, R23, R31, R33, R34, R35, R37, R39, R43, R47, R53, R56: 10K; R_0402_1005Metric; PartNumber RC0402FR-0710KL
R36: 0R; R_0402_1005Metric; PartNumber RC0402JR-070RL
R40: 3M; R_0402_1005Metric; PartNumber RC0402FR-073ML
R41: 1M; R_0402_1005Metric; PartNumber RC0402FR-071ML
R42: 16.2K; R_0402_1005Metric; PartNumber RC0402FR-0716K2L
R44: 8.25K; R_0402_1005Metric; PartNumber RC0402FR-078K25L
R46: 5.11K; R_0402_1005Metric; PartNumber RC0402FR-075K11L
R58, R59: 4.7K; R_0402_1005Metric; PartNumber RC0402JR-074K7L
U1: BC66NADA-04-STD; Quectel_BC66; PartNumber BC66NADA-04-STD
U2: TXS0108EPW; TSSOP-20_4.4x6.5mm_P0.65mm; PartNumber TXS0108EPW
U3: TPS63900; DFN-10-1EP_3x3mm_P0.5mm_EP1.65x2.38mm_ThermalVias; PartNumber TPS63900DSKR
U4: AT25SF321B-SSHB-T; SOIC-8_3.9x4.9mm_P1.27mm; PartNumber AT25SF321B-SSHB-T
U5: MIC5504-3.3YM5; SOT-23-5; PartNumber MIC5504-3.3YM5
U6: EFM32TG11B320F128GQ64-B; TQFP-64_10x10mm_P0.5mm; PartNumber EFM32TG11B320F128GQ64-B
U7: LIS3DH; LGA-16_3x3mm_P0.5mm_fixed; PartNumber LIS3DH
U8: MCP1727-3302E_MF; VDFN-8-1EP_2x2mm_P0.5mm_EP0.9x1.7mm; PartNumber MCP1727-3302E_MF
U9: Si7055-A20; DFN-6-1EP_3x3mm_P1mm_EP1.5x2.4mm; PartNumber Si7055-A20
Y1: 32.768kHz; Crystal_SMD_3215-2Pin_3.2x1.5mm; PartNumber CM315D32768DZFT
Y2: ABM8-48-000MHZ; Crystal_SMD_3225-4Pin_3.2x2.5mm; PartNumber ABM8-48.000MHZ-10-1-U-T

Connections:
3V3_ENBL: R53.1, U5.3 (EN), U6.18 (PA13)
+1V8: C27.1, C36.1, U1.24 (VDD_EXT), U2.2 (VCCA), U2.10 (OE)
+3.3VADC: C47.1, C50.1, FB1.2, U6.23 (AVDD), U6.27 (AVDD)
+3.3VP: C54.1, C56.1, C57.1, C60.1, C61.1, C62.1, D21.1 (K), FB1.1, U6.7 (IOVDD0), U6.26 (IOVDD0), U6.39 (DVDD), U6.55 (IOVDD0)
+3V3: C38.1, C53.1, C58.1, C59.2, C65.1, Q6.2 (S), R38.1, R43.1, U5.5 (VOUT), U7.1 (VDD_IO), U7.14 (VDD), U9.5 (VDD)
+BATT: C1.1, C2.1, C6.1, C23.1, C24.1, C25.1, C29.1, C30.1, C32.1, C55.1, C64.1, D14.1 (A1), D21.2 (A), F1.1, J1.2, J2.4, J3.4, J4.1, J8.4, R25.2, R29.2, R40.1, R58.2, R59.2, U2.19 (VCCB), U3.10 (VIN), U8.1 (VIN), U8.2 (VIN)
ADC0: C8.1, D5.1 (A1), R3.1, U6.32 (PD4)
ADC1: C4.1, D3.1 (A1), R4.1, U6.33 (PD5)
BC66_ON_OFF: R12.1, U6.9 (PB3)
BC66_PWR: R21.1, U6.10 (PB4)
BC66_PWRKEY: Q4.3 (C), U1.7 (PWRKEY)
BC66_RESET: Q3.3 (C), U1.15 (~RESET)
BC66_RI: U1.20 (RI), U2.1 (A1)
BC66_RST: R14.1, U6.31 (PD3)
BC66_RXD: U1.18 (RXD), U2.3 (A2)
BC66_RXD_AUX: U1.28 (RXD_AUX), U2.5 (A4)
BC66_RXD_DBG: U1.38 (RXD_DBG), U2.7 (A6)
BC66_TXD: U1.17 (TXD), U2.4 (A3)
BC66_TXD_AUX: U1.29 (TXD_AUX), U2.6 (A5)
BC66_TXD_DBG: U1.39 (TXD_DBG), U2.8 (A7)
CS: U6.47 (PC14), U7.8 (CS)
EXT_RXD: C12.1, D9.1 (A1), R7.1, U2.17 (B3)
EXT_RXD_DBG: C34.1, D19.1 (A1), R27.1, U2.13 (B7)
EXT_TXD: C10.1, D7.1 (A1), R8.1, U2.18 (B2)
EXT_TXD_DBG: C31.1, D16.1 (A1), R28.1, U2.14 (B6)
FLASH_PWR: R48.1, U6.5 (PA4)
GND: C1.2, C2.2, C3.2, C4.2, C5.2, C6.2, C7.2, C8.2, C9.2, C10.2, C11.2, C12.2, C13.2, C14.2, C15.2, C16.2, C17.2, C18.2, C19.2, C20.2, C21.2, C22.2, C23.2, C24.2, C25.2, C26.2, C27.2, C28.2, C29.2, C30.2, C31.2, C32.2, C33.2, C34.2, C35.2, C36.2, C37.2, C38.2, C39.2, C40.2, C41.2, C42.2, C43.2, C44.2, C45.2, C46.2, C47.2, C48.2, C49.2, C50.2, C51.2, C52.2, C53.2, C54.2, C55.2, C56.2, C57.2, C58.2, C59.1, C60.2, C61.2, C62.2, C63.2, C64.2, C65.2, C66.2, D1.2 (A2), D2.2 (GND), D3.2 (A2), D4.2 (A2), D5.2 (A2), D6.2 (A2), D7.2 (A2), D8.2 (A2), D9.2 (A2), D10.2 (A2), D11.2 (A2), D12.2 (A2), D13.2 (A2), D14.2 (A2), D15.2 (A2), D16.2 (A2), D17.2 (A2), D19.2 (A2), D20.2 (A2), D22.1 (K), D23.1 (K), J1.7, J2.2, J3.2, J4.2, J5.2, J6.5 (GND), J8.2, J10.1, Q1.2 (E), Q3.2 (E), Q4.2 (E), Q5.2 (E), Q7.2 (E), R15.2, R19.2, R22.2, R23.2, R31.2, R33.2, R34.2, R35.2, R37.2, R39.2, R41.2, R42.2, R44.2, R46.2, R47.2, R53.2, R56.2, U1.1 (GND), U1.10 (SIM_GND), U1.27 (GND), U1.34 (GND), U1.36 (GND), U1.37 (GND), U1.40 (GND), U1.41 (GND), U2.11 (GND), U3.8 (GND), U3.11 (PAD), U4.4 (GND), U5.2 (GND), U6.8 (VSS), U6.22 (VSS), U6.56 (VSS), U7.5 (GND), U7.10 (GND), U7.12 (GND), U8.4 (GND), U8.5 (GND), U8.9 (PAD), U9.2 (GND), Y2.2, Y2.4
GPIO0: C7.1, D4.1 (A1), R1.1, U6.21 (PB11)
GPIO1: C3.1, D1.1 (A1), R2.1, U6.12 (PB6)
INT1: U6.44 (PE7), U7.11 (INT1)
LED1: R54.1, U6.53 (PF4)
LED2: R55.1, U6.54 (PF5)
MCU_CLK: R51.2, U4.6 (SCK)
MCU_CS: R52.2, U4.1 (~CS~)
MCU_EM4WU4: C28.1, D17.1 (A1), R24.1, R33.1, U6.51 (PF2)
MCU_EM4WU5: C26.1, D15.1 (A1), R26.1, R31.1, U6.62 (PE13)
MCU_EM4WU6: C33.1, D20.1 (A1), R30.1, R35.1, U6.13 (PC4)
MCU_MISO: R50.2, U4.2 (SO/IO1)
MCU_MOSI: R49.2, U4.5 (SI/IO0)
MCU_RESET: C13.1, C49.1, D10.1 (A1), R18.1, U6.20 (~RESET~)
MCU_RI: U2.20 (B1), U6.30 (PD2)
MCU_RX0: C11.1, D8.1 (A1), R5.1, U6.60 (PE11)
MCU_RX1: U2.15 (B5), U6.29 (PD1)
MCU_SWCLK: C17.1, D12.1 (A1), R16.1, U6.49 (PF0)
MCU_SWDIO: C15.1, D11.1 (A1), R17.1, U6.50 (PF1)
MCU_TX0: C9.1, D6.1 (A1), R6.1, U6.59 (PE10)
MCU_TX1: U2.16 (B4), U6.28 (PD0)
unnamed: C14.1, D2.4 (IO3), J6.2 (RST), R9.2
unnamed: C16.1, D2.5 (IO4), J6.3 (CLK), R10.2
unnamed: C18.1, C20.1, D13.1 (A1), Q2.3 (D), U1.42 (VBAT_BB), U1.43 (VBAT_RF)
unnamed: C19.1, D2.6 (IO5), J6.7 (I/O), R11.2, R20.1
unnamed: C21.1, J6.SH, R22.1
unnamed: C35.1, R36.2, U1.35 (RF_ANT)
unnamed: C37.1, J10.2, R36.1
unnamed: C39.1, U6.15 (PB7), Y1.1
unnamed: C40.1, R40.2, R41.1, R45.2
unnamed: C42.1, U6.16 (PB8), Y1.2
unnamed: C43.1, U6.24 (PB13), Y2.1
unnamed: C46.1, U6.25 (PB14), Y2.3
unnamed: C51.1, Q6.3 (D), U4.8 (VCC)
unnamed: C52.1, U6.40 (DECOUPLE)
unnamed: C63.1, R57.1
unnamed: D18.1 (K), Q5.3 (C)
unnamed: D18.2 (A), R38.2
unnamed: D22.2 (A), R54.2
unnamed: D23.2 (A), R55.2
unnamed: F1.2, J5.1
unnamed: J1.3, R1.2
unnamed: J1.4, R2.2
unnamed: J1.5, R3.2
unnamed: J1.6, R4.2
unnamed: J2.1, R5.2
unnamed: J2.3, R6.2
unnamed: J3.1, R7.2
unnamed: J3.3, R8.2
unnamed: J4.3, R16.2
unnamed: J4.4, R17.2
unnamed: J4.5, R18.2
unnamed: J7.1, R24.2
unnamed: J7.2, R25.1
unnamed: J7.3, R26.2
unnamed: J8.1, R27.2
unnamed: J8.3, R28.2
unnamed: J9.1, R29.1
unnamed: J9.2, R30.2
unnamed: L1.1, U3.9 (LX1)
unnamed: L1.2, U3.7 (LX2)
unnamed: Q1.1 (B), R12.2, R15.1
unnamed: Q1.3 (C), Q2.1 (G), R13.2
unnamed: Q3.1 (B), R14.2, R19.1
unnamed: Q4.1 (B), R21.2, R23.1
unnamed: Q5.1 (B), R32.2, R34.1
unnamed: Q6.1 (G), Q7.3 (C), R43.2
unnamed: Q7.1 (B), R47.1, R48.2
unnamed: R32.1, U1.16 (NETLIGHT)
unnamed: R42.1, U3.5 (CFG3)
unnamed: R44.1, U3.4 (CFG2)
unnamed: R46.1, U3.3 (CFG1)
unnamed: R49.1, U6.1 (PA0)
unnamed: R50.1, U6.2 (PA1)
unnamed: R51.1, U6.3 (PA2)
unnamed: R52.1, U6.4 (PA3)
unnamed: R57.2, U6.36 (PD8)
SCL: R58.1, U6.41 (PE4), U7.4 (SCL/SPC), U9.6 (SCL)
SDA: R59.1, U6.42 (PE5), U7.6 (SDA/SDI/SDO), U9.1 (SDA)
SDO: U6.48 (PC15), U7.7 (SDO/SA0)
SENS_ENBL: R56.1, U6.6 (PA5), U8.3 (~EN~)
SIM_CLK: R10.1, U1.13 (SIM_CLK)
SIM_DATA: R11.1, U1.11 (SIM_DATA)
SIM_RST: R9.1, U1.12 (SIM_RST)
SIM_VDD: C22.1, J6.1 (VCC), R20.2, U1.14 (SIM_VDD)
SW_ENBL: R37.1, U3.1 (EN), U6.19 (PA14)
VBAT_MON: R45.1, U6.35 (PD7)
VCC: C5.1, C41.1, C44.1, C45.1, C48.1, Q2.2 (S), R13.1, U3.6 (VOUT), U5.1 (VIN)
VCCQ: C66.1, J1.1, U8.7 (VSNS), U8.8 (VOUT)
V_SELECT: R39.1, U3.2 (SEL), U6.17 (PA12)

Notes on the sheet:
1x100uF + 1x10uF bulk decoupling + 100nF per power pin
CL = 2*(Cload-Cstray)
Cload = 12.5pF
Cstray = 3..5pF
Cload = 10pF
Temp sensor ± 0.5 ºC, I2C line
Main MCU EFM32TG11B320F128GQ64-B
Accelerometer LIS3DHTR 16-LGA (3x3)
FLASH - NOR 32Mb (4M x 8) SPI
Power select Pull V_SEL high for M66 modem (4V output) Pull V_SEL low for BC66-NA modem (3.3V output)
FLASH
FLASH power on/off
BC66 power on/off
BC66 reset control
BC66 PWR key
NB-IoT modem BC66-NA
I2C bus
UART0
SWD
UART1 (modem control)
Power supply controller TPS63900 + MIC29302WU
3V3<->1V8 signal levels translator
VBAT voltage monitor
MCU UART
SIG
GND
Modem main UART
Modem debug UART
MCU SWD
SWCLK
SWDIO
~RESET~
Power control
VBAT in
External connectors
VCC: 3.3V or 4V
SIM card slot
Connect reed switch here
Pin to wake-up MCU from EM4 sleep
Service
SIG1
SIG2
WKUP
USER LED
Test LEDs
Mounting
Filter to reduce noise at AVDD pin (bead + 1x10uF+1x0.1uF)
ADC Inputs
RTC EDLC
LIS3DHTR ADR/CS pins
External GPIO
PB11 - EM4WU7
GPIO output
ADC inputs
Power output
External sensors regulator
External sensors

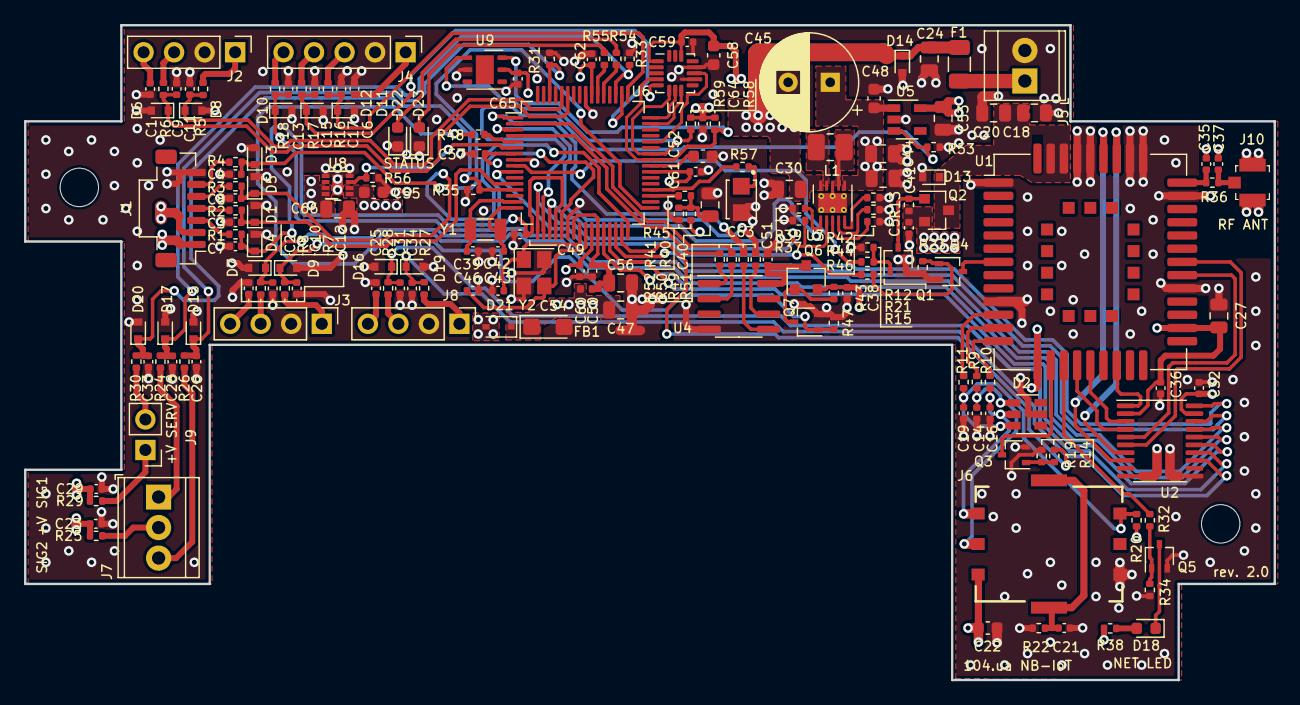
[picture p13: board Smart104.ua_V3_rev2.kicad_pcb from above]

Board: 4 copper layers, 104.0 x 54.5 mm, 181 parts (0 on the bottom side), 116 nets.
