Tesla900/GSMLinkModem/(commit log)

2020-11-24 new: Initial commit
    [GSMLinkModem.kicad_pcb, GSMLinkModem.sch]
2020-11-24 new: Work in progress
    [GSMLinkModem.sch]
2020-12-09 new: Rev. 1.0
    [GSMLinkModem.kicad_pcb, GSMLinkModem.sch]
2020-12-10 new: Rev. 1.0 gerbers/fixes
    [GSMLinkModem.kicad_pcb, GSMLinkModem.sch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]
2020-12-14 new: Rev. 1.0 gerbers/fixes_2
    [ConnectorsLayout.xlsx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]
2020-12-20 fix: Rev. 1.0 connector added, pcb fixes
    [Smart104.ua_V3.kicad_pcb, Smart104.ua_V3.sch]
2020-12-21 fix: Rev. 1.0 production files added
    [ConnectorsLayout.xlsx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]
2021-01-17 new: Rev. 1.0 LGA-16 footprint fixed, minor fixes
    [Smart104.ua_V3-Edge_Cuts.gm1, Smart104.ua_V3-F_Mask.gts, Smart104.ua_V3_rev2-B_Cu.gbl, Smart104.ua_V3_rev2-B_Mask.gbs, Smart104.ua_V3_rev2-B_SilkS.gbo, Smart104.ua_V3_rev2-F_Cu.gtl, Smart104.ua_V3_rev2-F_Mask.gts, Smart104.ua_V3_rev2-F_SilkS.gto]
